sachenpather/EEE3088F_FinalReport_Group16/README.md

# EEE3088F_FinalReport_Group16

This Repository pertains to EEE3088F Interim Design Report for the construction and design of a micromouse. 
The contents of this repository are latex files for the design report and datasheets relating to the design reports

The power subsection is done by Keturah Naidoo, NDXKET001 and
The sensing subsection is done by Sachen Pather PTHSAC002
