sachenpather/EEE3088F_FinalReport_Group16/Sensing_InterimDesign_report/EEE3088F_final_report_latex_template-2/EEE3088F_final_report_latex_template-2/FrontMatter/Title.tex

\thispagestyle{empty}
\begin{center}
    
\Huge

\vspace{5cm}

% Title
Interim Design Report

\vspace{0.1cm}
\large
Micromouse X Subsystem

\vspace{2cm}
% UCT logo
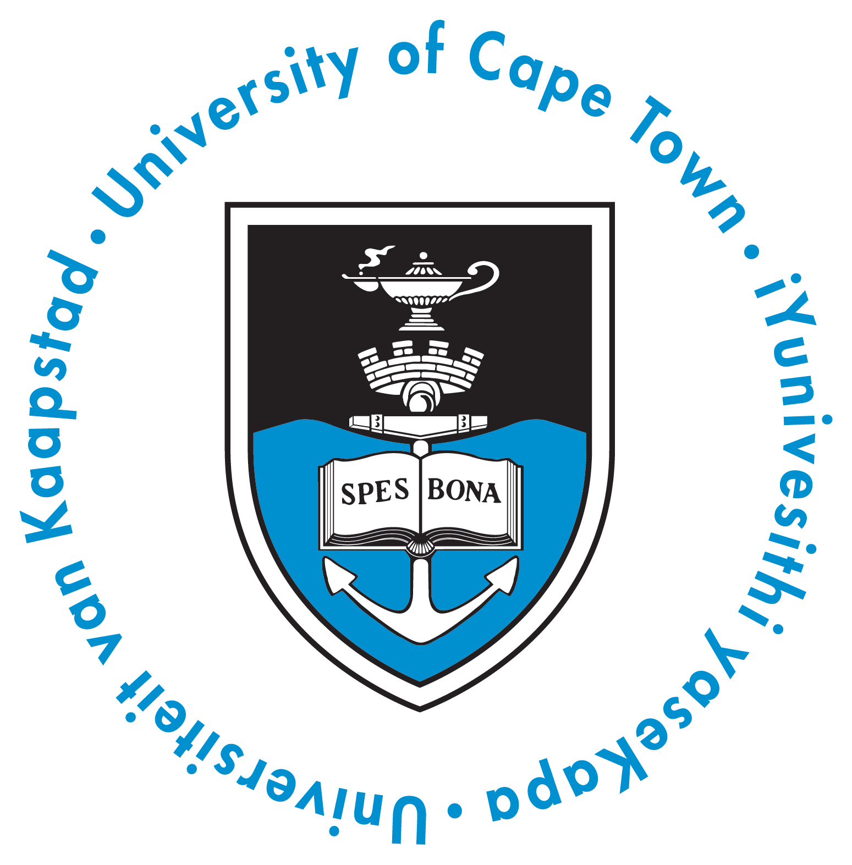
[picture p6: Sensing_InterimDesign_report/EEE3088F_final_report_latex_template-2/FrontMatter/UCT_logo.png]


\vfill

% My name
\large
\textbf{Prepared by:}\\
Sachen Pather

\vspace{1cm}

% My supervisor's name
\textbf{Prepared for:}\\
EEE3088F\\
Department of Electrical Engineering\\
University of Cape Town

\vspace{2cm}

% Today's date
\today

% To add keywords?
% \vspace{2cm}
% \textbf{Keywords:} Keywords here

\end{center}
