sachenpather/EEE3088F_FinalReport_Group16/Sensing_InterimDesign_report/EEE3088F_final_report_latex_template-2/EEE3088F_final_report_latex_template-2/Figures/Final_Schematic.jpg

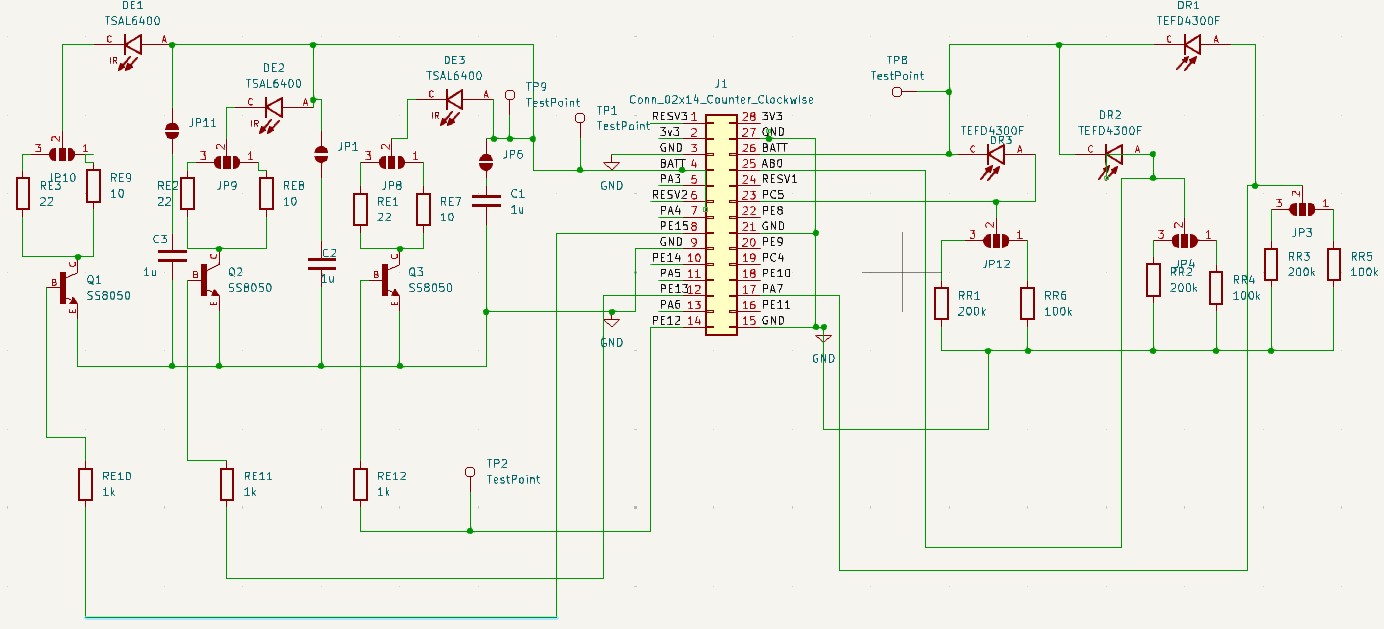
Sensing_InterimDesign_report/EEE3088F_final_report_latex_template-2/EEE3088F_final_report_latex_template-2/Figures/Final_Schematic.jpg
