sachenpather/EEE3088F_FinalReport_Group16/Power_InterimDesignReport/power subsystem/LIB_DRV8833PWPR/DRV8833PWPR/3D/DRV8833PWPR.stp

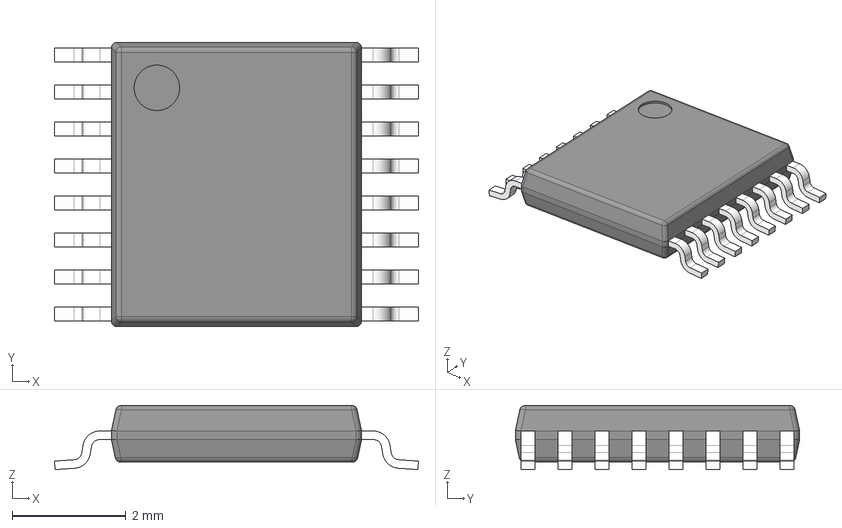
[picture p10: CAD file, 2024-04-21, last stored version]
Power_InterimDesignReport/power subsystem/LIB_DRV8833PWPR/DRV8833PWPR/3D/DRV8833PWPR.stp
6.40 x 5.00 x 1.13 mm
BODY-TSSOP
LEAD-TSSOP x 16
PIN1
DAP
