sachenpather/EEE3088F_FinalReport_Group16/Power_InterimDesignReport/power subsystem/LIB_MCP73831T-2ATI_OT/MCP73831T-2ATI_OT/3D/MCP73831T-2ATI_OT.stp

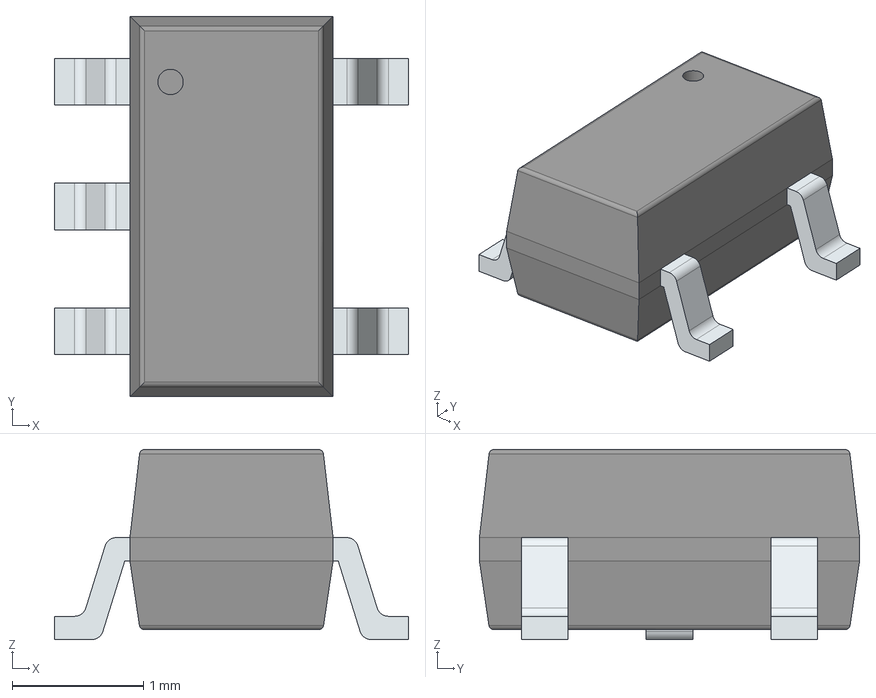
[picture p11: CAD file, 2024-04-21, last stored version]
Power_InterimDesignReport/power subsystem/LIB_MCP73831T-2ATI_OT/MCP73831T-2ATI_OT/3D/MCP73831T-2ATI_OT.stp
2.70 x 2.90 x 1.45 mm
PinsArrayL
PinsArrayR
