sachenpather/EEE3088F_FinalReport_Group16/(list of files, cad)

Other CAD files:
Power_InterimDesignReport/power subsystem/LIB_DRV8833PWPR/DRV8833PWPR/Allegro/sop65p640x120-16n.psm
Power_InterimDesignReport/power subsystem/LIB_DRV8833PWPR/DRV8833PWPR/DEHDL/drv8833pwpr/chips/chips.prt
Power_InterimDesignReport/power subsystem/LIB_MCP73831T-2ATI_OT/MCP73831T-2ATI_OT/Allegro/sot95p270x145-5n.psm
Power_InterimDesignReport/power subsystem/LIB_MCP73831T-2ATI_OT/MCP73831T-2ATI_OT/DEHDL/mcp73831t_2ati_ot/chips/chips.prt
