sachenpather/EEE3088F_FinalReport_Group16/Power_InterimDesignReport/power subsystem/neat schematic.pdf

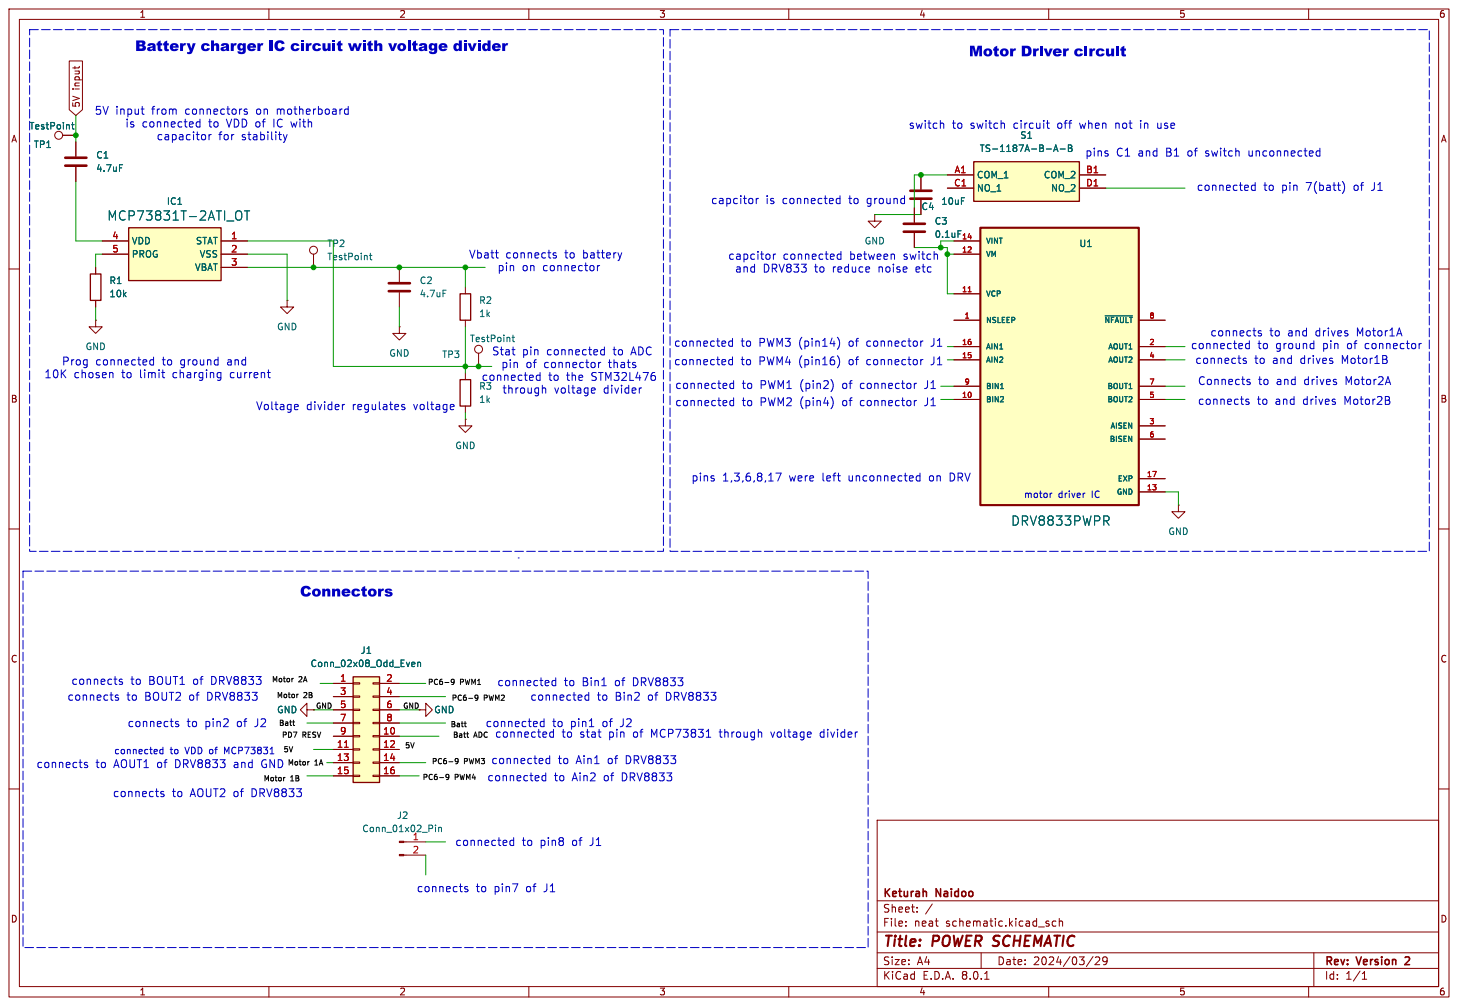
[picture p12: page 1]

and DRV833 to reduce noise etc

through voltage divider GND

Id: 1/1 Title: POWER SCHEMATIC
