sachenpather/EEE3088F_FinalReport_Group16/(list of files, drawings)

Other design files:
Power_InterimDesignReport/power subsystem/LIB_DRV8833PWPR/DRV8833PWPR/Altium/DRV8833PWPR.SchLib
Power_InterimDesignReport/power subsystem/LIB_DRV8833PWPR/DRV8833PWPR/Altium/SOP65P640X120-16N.PcbLib
Power_InterimDesignReport/power subsystem/LIB_MCP73831T-2ATI_OT/MCP73831T-2ATI_OT/Altium/MCP73831T-2ATI_OT.SchLib
Power_InterimDesignReport/power subsystem/LIB_MCP73831T-2ATI_OT/MCP73831T-2ATI_OT/Altium/SOT95P270X145-5N.PcbLib
