sachenpather/EEE3088F_FinalReport_Group16/Sensing_InterimDesign_report/EEE3088F_final_report_latex_template-2/EEE3088F_final_report_latex_template-2/Chapters/04AcceptanceTesting.tex

% ----------------------------------------------------
% Acceptance Testing
% ----------------------------------------------------
\documentclass[class=report,11pt,crop=false]{standalone}
\input{../Style/ChapterStyle.tex}
\begin{document}
% ----------------------------------------------------
\chapter{Acceptance Testing} \label{ch:atp}
\vspace{-1cm}
\\ \\
\begin{table}[h]
  \centering
    \caption{Subsystem Acceptance Tests}
    \label{tab:tests}
    \begin{tabular}{ >{\centering\arraybackslash}m{1cm}  m{4cm} m{5cm} m{5cm}}
      \hline
      \textbf{Test ID} & \textbf{Description} & \textbf{Testing Procedure}& \textbf{Pass/Fail Criteria} \\   
      \hline
      AT01 & Battery Voltage Check - see if subsystem battery provides adequate power (Tests R01, SP01)  & Use IR Emitter and IR Receiver circuit battery test points (TP1 and TP8) to measure battery voltage. & Battery voltage is within acceptable range (e.g., 3.7V for lithium-ion battery). \\
       \hline
      AT02 & Size check - see if subsystem fits given dimensions (Tests R02, SP02) & Measure physical dimensions of the pcb board & Should measure approximately 85mm width and 50mm height \\
       \hline
      AT03 & Cost check - check if subsystem meets the budget constraint(Tests R03, SP03)  & Upload the gerber files onto JLCPCB and generate instant an quote & Total cost should display less than \$30 \\
      \hline
      AT04 & Voltage Output Verification (Tests R04, SP04)  & Use output voltage test points (TP3, TP4, TP5) to measure output voltages at specified distances from a wall on the left, right and front. & Output voltages should increase when close to the wall and decrease when further away. \\
      \hline
      AT05 & Differentiation between left, right and front (Tests R05, SP05) & Similar to AT04, use output voltage test points (TP3, TP4, TP5) to measure output voltages at roughly 60mm from a wall on the left, right and front and feed through analogue input. & LED for each specific direction should light up accordingly powered by the microcontroller's ADC \\
      \hline
      AT06 & Power Saving mode check(Tests R06, SP06)  & Vary duty cycle from 100\% to 50\% and time how long until the battery drains. Use a multi-meter to measure current using jumpers (JP10, JP9, JP8). &  Current through multi-meter should be roughly half at 50\% than at 100\% duty cycle. Battery drain time should be approximately double at 50\% duty cycle than at 100\% duty cycle  \\
      \hline
    \end{tabular}
\end{table}

% ----------------------------------------------------
\ifstandalone
\bibliography{../Bibliography/References.bib}
\fi
\end{document}
% ----------------------------------------------------
